toancst/Gas-Detection-Systems/Diagram/pin-out.png

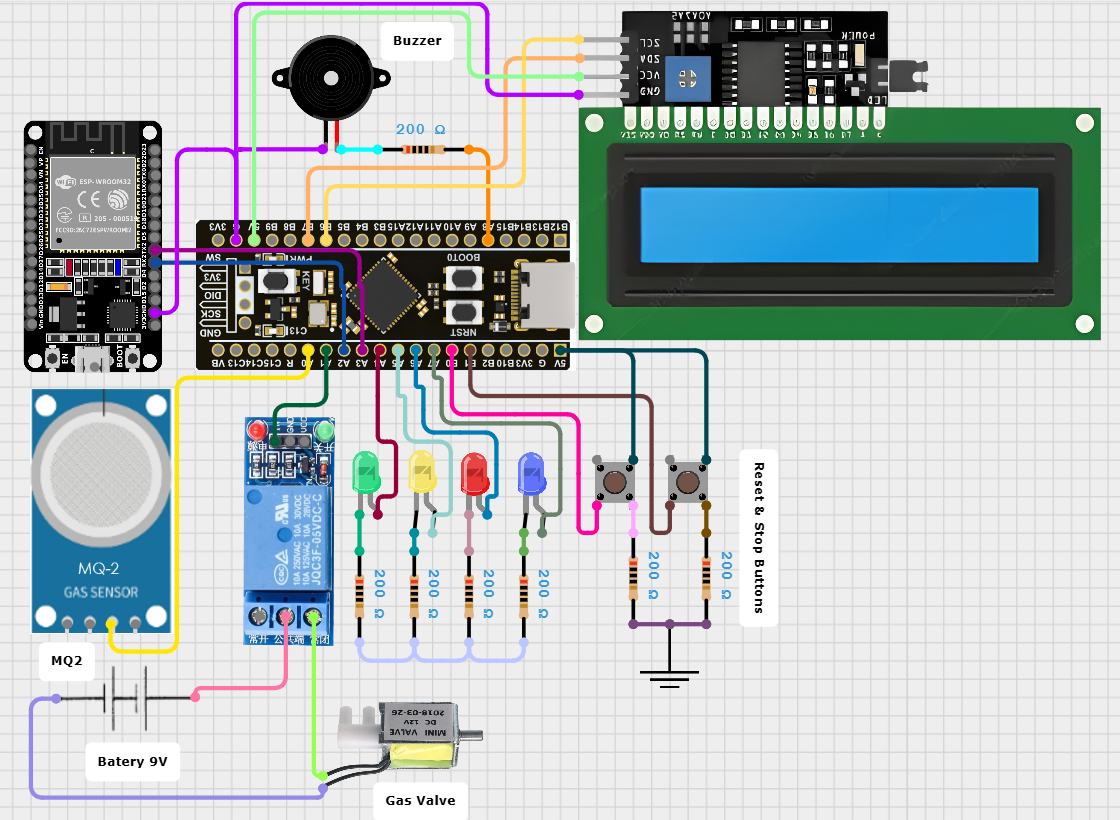
Diagram/pin-out.png
