toancst/Gas-Detection-Systems/README.md

[View document](./THIẾT KẾ VÀ THỰC HIỆN HỆ THỐNG PHÁT HIỆN VÀ CẢNH BÁO  RÒ RỈ KHÍ GAS TRONG NHÀ.docx.pdf)
