toancst/Gas-Detection-Systems/stm/lcd_library/STM32_Multiple_I2C_LCD/STM32_Multiple_I2C_LCD.ioc

Mcu.UserName=STM32F103C8Tx
PB6.Signal=I2C1_SCL
PB7.Signal=I2C1_SDA
PD0-OSC_IN.Signal=RCC_OSC_IN
PD1-OSC_OUT.Signal=RCC_OSC_OUT
